enriquewph/TD1-MiniLab/hw-minilab/bornera.png

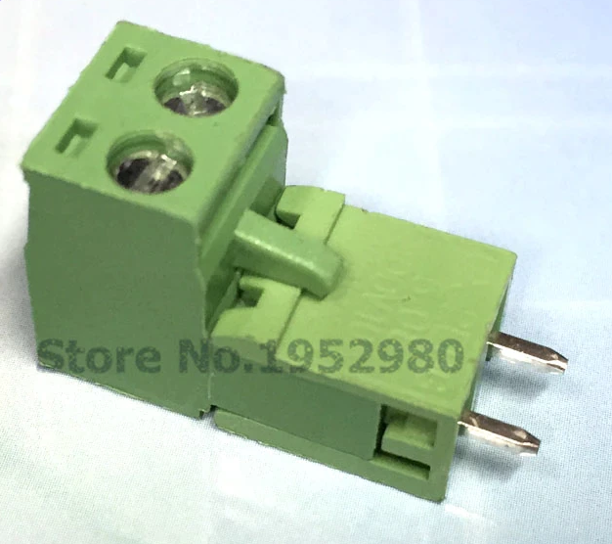
hw-minilab/bornera.png
