enriquewph/TD1-MiniLab/CAD/Render A.JPG

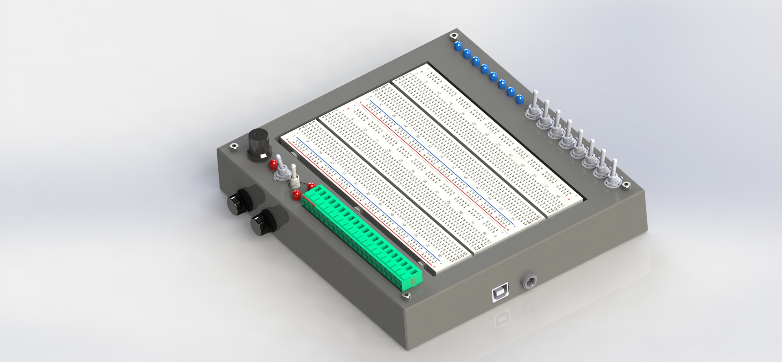
CAD/Render A.JPG
