enriquewph/TD1-MiniLab/README.md

# TD1-MiniLab
Practico de Laboratorio N° 1. --- Mini Lab ---
