enriquewph/TD1-MiniLab/CAD/render 1.JPG

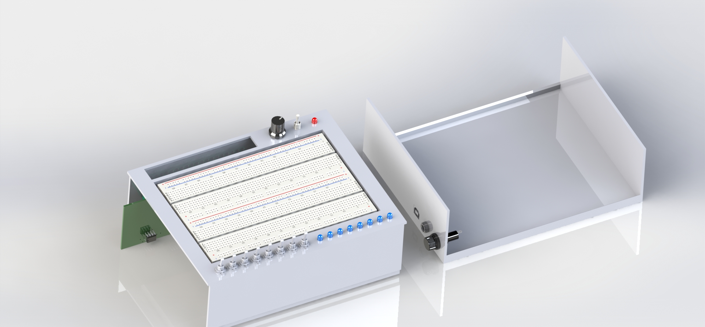
CAD/render 1.JPG
