enriquewph/TD1-MiniLab/CAD/Render B.JPG

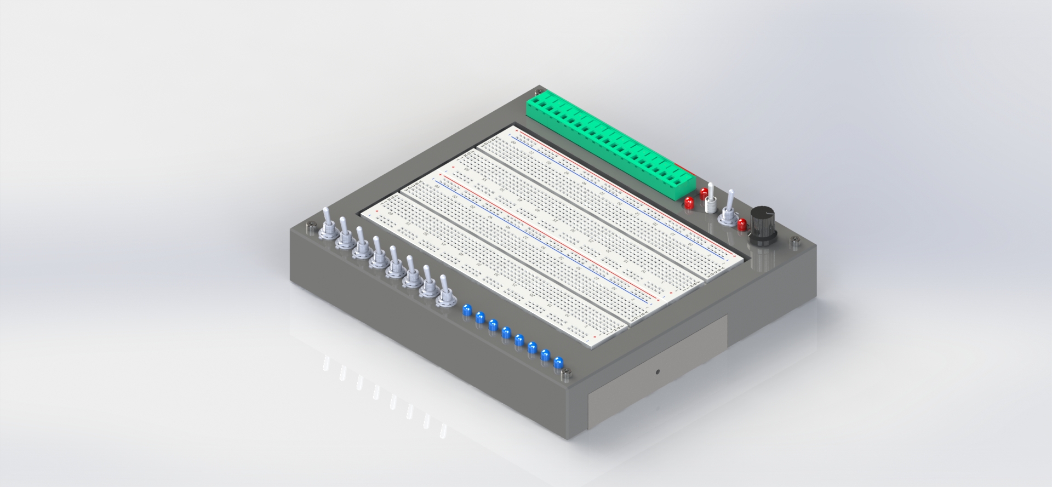
CAD/Render B.JPG
