enriquewph/TD1-MiniLab/hw-minilab/docs/BOM.xlsx

Sheet: Resumen
Item | Cantidad | Descripción | Valor | Cant. Necesaria Total | Cant. Obtenida | Excedentes | Costo c/u | Costo total | Costo x Minilab
1 | 1 | C. Integrado | NE555P | 4 | 6 | 2 | $209.05 | $1254.32 | $313.58
2 | 1 | C. Integrado | L7805 | 4 | 4 | 0 | $40.84 | $163.36 | $40.84
3 | 1 | C. Integrado | KF33 | 4 | 4 | 0 | $40.84 | $163.36 | $40.84
4 | 2 | C. Integrado | CD4069 | 8 | 12 | 4 | $109.20 | $1310.40 | $327.60
5 | 1 | Cap. Cerámico 50V | 470nF | 4 | 4 | 0 | $18.20 | $72.80 | $18.20
6 | 8 | Cap. Cerámico 50V | 100nF | 32 | 32 | 0 | $7.00 | $224.00 | $56.00
7 | 2 | Cap. Electrolítico 16V | 10uF | 8 | 8 | 0 | $3.91 | $31.31 | $7.83
8 | 2 | Cap. Electrolítico 16V | 100uF | 8 | 8 | 0 | $3.91 | $31.31 | $7.83
9 | 7 | Conector Bornera 3 Pos. 5.08mm | - | 28 | 28 | 0 | $85.00 | $2380.00 | $595.00
10 | 1 | Conector DC Estándar p/gab | - | 4 | 4 | 0 | $100.00 | $400.00 | $100.00
11 | 1 | Diodo Rectificador | 1N4007 | 4 | 4 | 0 | $2.50 | $10.00 | $2.50
12 | 1 | Disipador TO220 7W | - | 4 | 4 | 0 | $0.00 | $0.00 | $0.00
13 | 7 | Enchufe Bornera 3 Pos. 5.08mm | - | 28 | 28 | 0 | $25.00 | $700.00 | $175.00
14 | 6 | Fusible 20mm | 250mA | 24 | 24 | 0 | $23.80 | $571.20 | $142.80
15 | 8 | Imanes Neodimio 5x1mm | - | 32 | 32 | 0 | $36.00 | $1152.00 | $288.00
16 | 8 | LED 5mm Azul | - | 32 | 32 | 0 | $5.00 | $160.00 | $40.00
17 | 3 | LED 5mm Rojo | - | 12 | 12 | 0 | $5.00 | $60.00 | $15.00
18 | 1 | Placa Virgen 20x20 | - | 1 | 1 | 0 | $266.00 | $266.00 | $66.50
19 | 2 | Portafusible p/gab | - | 8 | 8 | 0 | $82.60 | $660.80 | $165.20
20 | 1 | Potenciometro p/gabinete | 1M | 4 | 4 | 0 | $138.60 | $554.40 | $138.60
21 | 1 | Power Bank barato 1x18650 | - | 4 | 4 | 0 | $800.00 | $3200.00 | $800.00
22 | 2 | Protoboard 830 puntos | - | 8 | 8 | 0 | $214.00 | $1712.00 | $428.00
23 | 1 | Resistencia 1/4 W | 2k7 | 4 | 50 | 46 | $1.54 | $76.87 | $19.22
24 | 11 | Resistencia 1/4 W | 470 | 44 | 50 | 6 | $1.54 | $76.87 | $19.22
25 | 16 | Resistencia 1/4 W | 10k | 64 | 100 | 36 | $1.54 | $153.73 | $38.43
26 | 9 | Switch Palanca ON/ON | SW_SPDT | 36 | 36 | 0 | $61.49 | $2213.72 | $553.43
27 | 1 | Switch Palanca ON/ON | SW_DPDT | 4 | 4 | 0 | $197.82 | $791.29 | $197.82
28 | 1 | USB Tipo B Hembra | - | 4 | 4 | 0 | $61.26 | $245.04 | $61.26
29 | 2 | Zocalo DIP 14 | - | 8 | 8 | 0 | $10.00 | $80.00 | $20.00
30 | 1 | Zocalo DIP 8 | - | 4 | 4 | 0 | $10.00 | $40.00 | $10.00
31 | 4 | Tornillos M3x20 | - | 16 | 16 | 0 | $20.00 | $320.00 | $80.00
32 | 7 | Tornillos M3x15 | - | 28 | 28 | 0 | $18.00 | $504.00 | $126.00
33 | 4 | Tuercas M3 | - | 16 | 16 | 0 | $2.00 | $32.00 | $8.00
Total |  |  |  |  |  |  |  |  | $4902.69

Sheet: Completo
Item | Cantidad | Descripción | Valor | Cant. Necesaria Total | Cant. Obtenida | Excedentes | Costo c/u | Costo total | Costo x Minilab
1 | 1 | C. Integrado | NE555P | 4 | 6 | 2 | $209.05 | $1254.32 | $313.58
2 | 1 | C. Integrado | L7805 | 4 | 4 | 0 | $40.84 | $163.36 | $40.84
3 | 1 | C. Integrado | KF33 | 4 | 4 | 0 | $40.84 | $163.36 | $40.84
4 | 2 | C. Integrado | CD4069 | 8 | 12 | 4 | $109.20 | $1310.40 | $327.60
5 | 1 | Cap. Cerámico 50V | 470nF | 4 | 4 | 0 | $18.20 | $72.80 | $18.20
6 | 8 | Cap. Cerámico 50V | 100nF | 32 | 32 | 0 | $7.00 | $224.00 | $56.00
7 | 2 | Cap. Electrolítico 16V | 10uF | 8 | 8 | 0 | $3.91 | $31.31 | $7.83
8 | 2 | Cap. Electrolítico 16V | 100uF | 8 | 8 | 0 | $3.91 | $31.31 | $7.83
9 | 7 | Conector Bornera 3 Pos. 5.08mm | - | 28 | 28 | 0 | $85.00 | $2380.00 | $595.00
10 | 1 | Conector DC Estándar p/gab | - | 4 | 4 | 0 | $100.00 | $400.00 | $100.00
11 | 1 | Diodo Rectificador | 1N4007 | 4 | 4 | 0 | $2.50 | $10.00 | $2.50
12 | 1 | Disipador TO220 7W | - | 4 | 4 | 0 | $0.00 | $0.00 | $0.00
13 | 7 | Enchufe Bornera 3 Pos. 5.08mm | - | 28 | 28 | 0 | $25.00 | $700.00 | $175.00
14 | 6 | Fusible 20mm | 250mA | 24 | 24 | 0 | $23.80 | $571.20 | $142.80
15 | 8 | Imanes Neodimio 5x1mm | - | 32 | 32 | 0 | $36.00 | $1152.00 | $288.00
16 | 8 | LED 5mm Azul | - | 32 | 32 | 0 | $5.00 | $160.00 | $40.00
17 | 3 | LED 5mm Rojo | - | 12 | 12 | 0 | $5.00 | $60.00 | $15.00
18 | 1 | Placa Virgen 20x20 | - | 1 | 1 | 0 | $266.00 | $266.00 | $66.50
19 | 2 | Portafusible p/gab | - | 8 | 8 | 0 | $82.60 | $660.80 | $165.20
20 | 1 | Potenciometro p/gabinete | 1M | 4 | 4 | 0 | $138.60 | $554.40 | $138.60
21 | 1 | Power Bank barato 1x18650 | - | 4 | 4 | 0 | $800.00 | $3200.00 | $800.00
22 | 2 | Protoboard 830 puntos | - | 8 | 8 | 0 | $214.00 | $1712.00 | $428.00
23 | 1 | Resistencia 1/4 W | 2k7 | 4 | 50 | 46 | $1.54 | $76.87 | $19.22
24 | 11 | Resistencia 1/4 W | 470 | 44 | 50 | 6 | $1.54 | $76.87 | $19.22
25 | 16 | Resistencia 1/4 W | 10k | 64 | 100 | 36 | $1.54 | $153.73 | $38.43
26 | 9 | Switch Palanca ON/ON | SW_SPDT | 36 | 36 | 0 | $61.49 | $2213.72 | $553.43
27 | 1 | Switch Palanca ON/ON | SW_DPDT | 4 | 4 | 0 | $197.82 | $791.29 | $197.82
28 | 1 | USB Tipo B Hembra | - | 4 | 4 | 0 | $61.26 | $245.04 | $61.26
29 | 2 | Zocalo DIP 14 | - | 8 | 8 | 0 | $10.00 | $80.00 | $20.00
30 | 1 | Zocalo DIP 8 | - | 4 | 4 | 0 | $10.00 | $40.00 | $10.00
Total |  |  |  |  |  |  |  |  | $4688.69
