enriquewph/TD1-MiniLab/CAD/Jack_DC.SLDASM

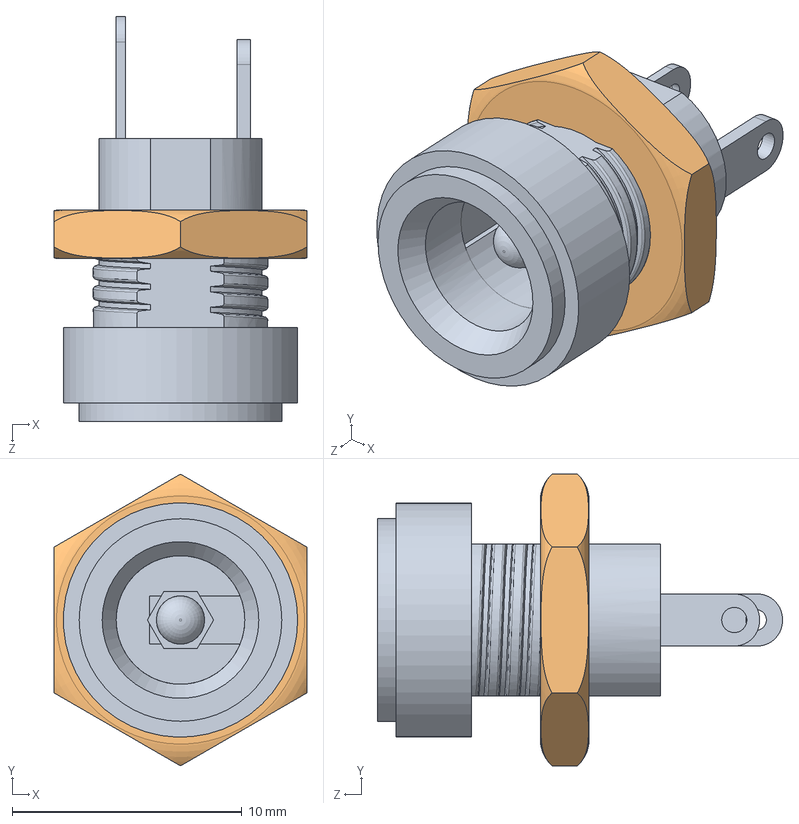
[picture p5: CAD file, 2022-03-29]
CAD/Jack_DC.SLDASM
11.0 x 12.7 x 17.6 mm
DC Jack Panel Mount Base_1
DC Jack Panel Mount Nut_1
