enriquewph/TD1-MiniLab/CAD/minilab-export.SLDASM

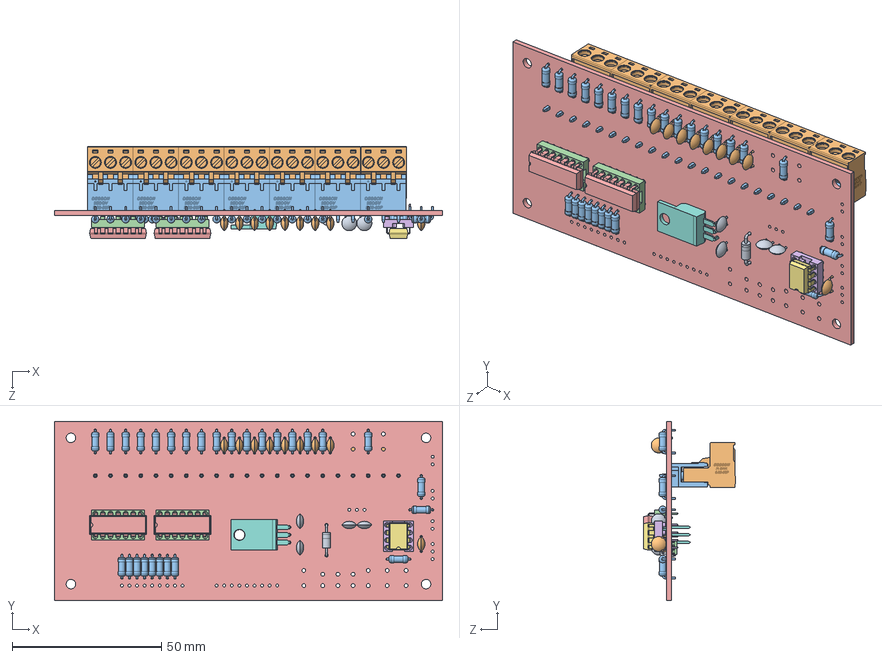
[picture p6: CAD file, 2022-03-29]
CAD/minilab-export.SLDASM
130.0 x 60.0 x 30.8 mm
SOLID.step x 4
SOLID-0.step x 9
SOLID-1.step x 28
SOLID-2.step x 2
SOLID-3.step x 2
SOLID-4.step
SOLID-5.step
SOLID-6.step
SOLID-7.step
SOLID-8.step x 7
SOLID-9.step x 7
SOLID-10.step
minilab PCB.step
