enriquewph/TD1-MiniLab/CAD/Pcb.SLDASM

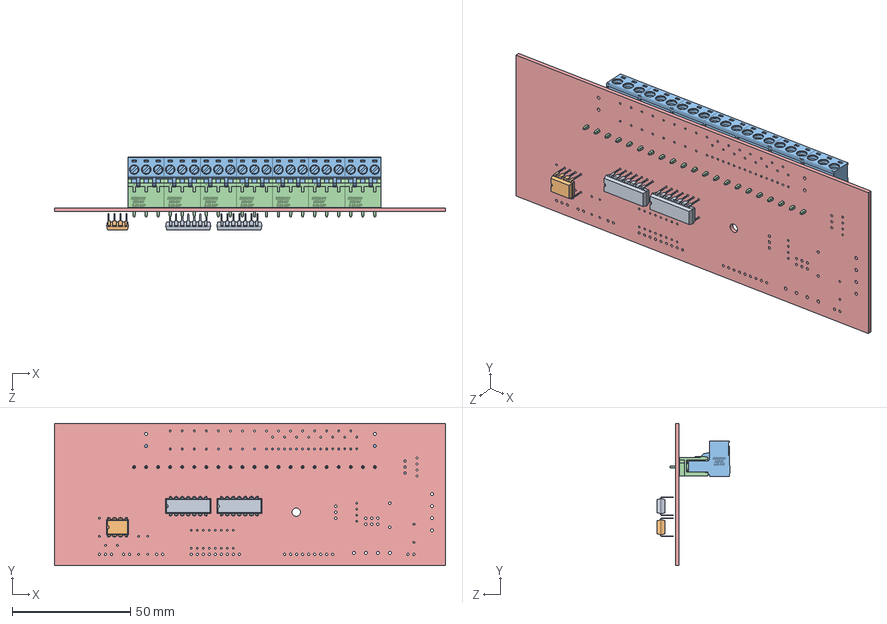
[picture p7: CAD file, 2022-03-29]
CAD/Pcb.SLDASM
165.0 x 60.0 x 30.8 mm
minilab PCB
