enriquewph/TD1-MiniLab/CAD/RTP/Base-Insertos.STL

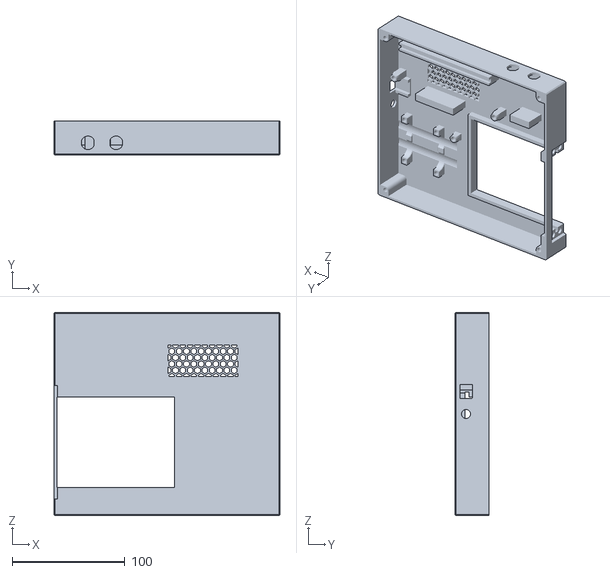
[picture p8: CAD file, 2022-03-29]
CAD/RTP/Base-Insertos.STL
200.0 x 30.5 x 180.0
