enriquewph/TD1-MiniLab/CAD/RTP/Tapa.STL

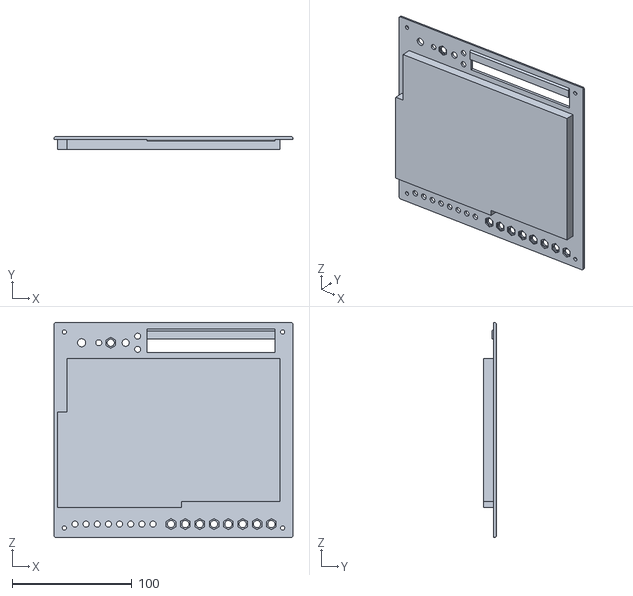
[picture p9: CAD file, 2022-03-29]
CAD/RTP/Tapa.STL
200.0 x 11.0 x 180.0
