enriquewph/TD1-MiniLab/CAD/Turn Knob.SLDPRT

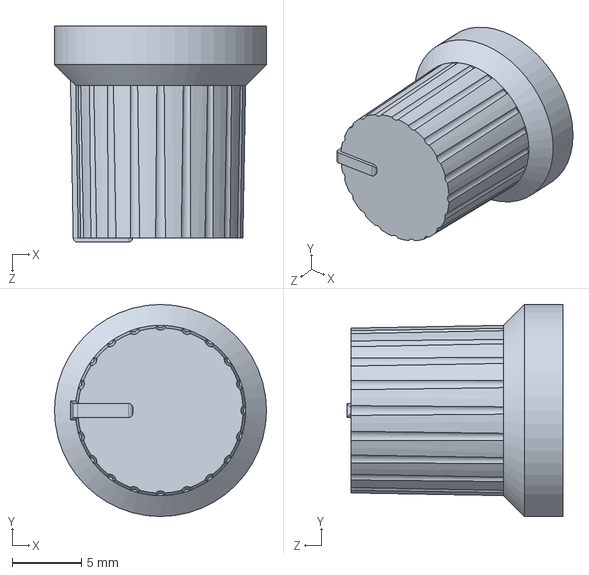
[picture p10: CAD file, 2022-03-29]
CAD/Turn Knob.SLDPRT
15.3 x 15.3 x 15.6 mm
