enriquewph/TD1-MiniLab/CAD/LED_BLUE.SLDPRT

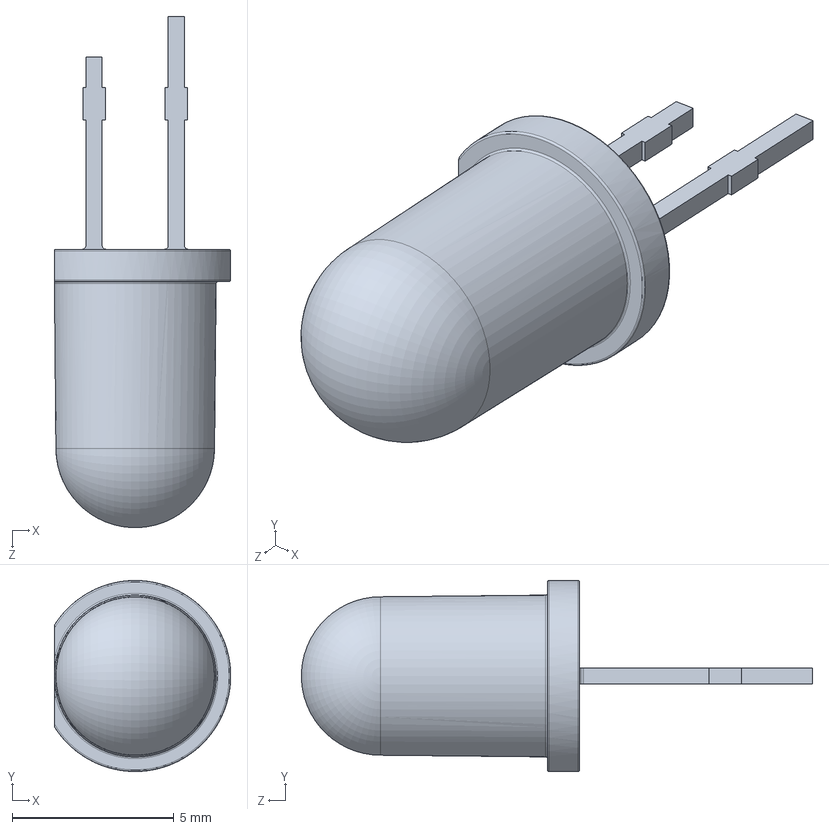
[picture p11: CAD file, 2022-03-29]
CAD/LED_BLUE.SLDPRT
5.45 x 5.90 x 15.8 mm
