enriquewph/TD1-MiniLab/CAD/RTP/Cajon.STL

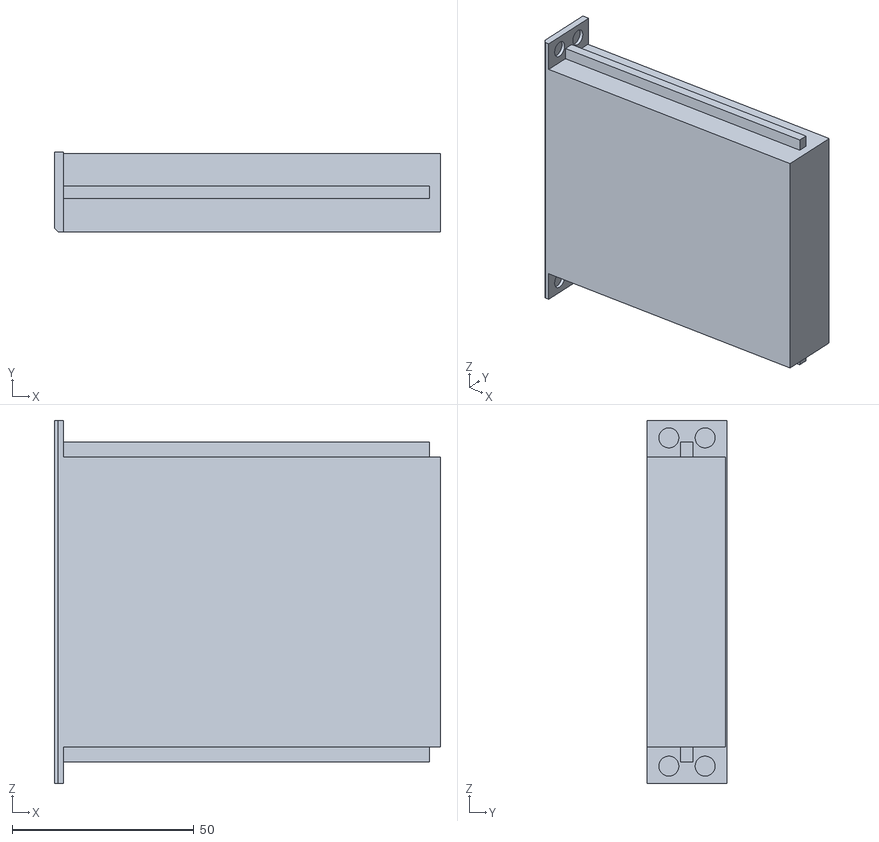
[picture p12: CAD file, 2022-03-29]
CAD/RTP/Cajon.STL
106.3 x 22.0 x 100.0
