enriquewph/TD1-MiniLab/CAD/RTP/Clips.STL

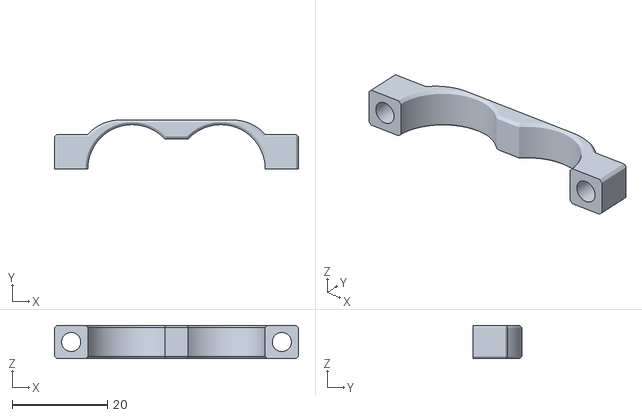
[picture p13: CAD file, 2022-03-29]
CAD/RTP/Clips.STL
51.2 x 10.3 x 7.00
