enriquewph/TD1-MiniLab/CAD/DPDTINVERSOR.SLDPRT

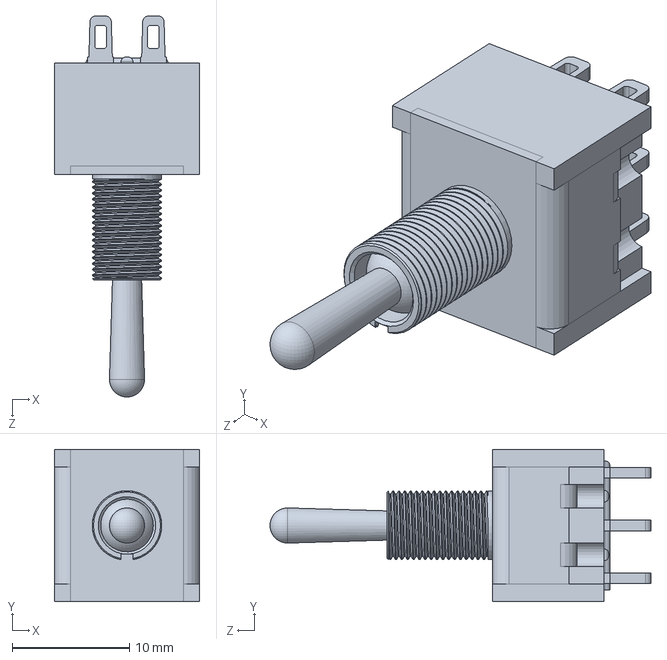
[picture p14: CAD file, 2022-03-29]
CAD/DPDTINVERSOR.SLDPRT
12.4 x 13.0 x 32.5 mm
