enriquewph/TD1-MiniLab/CAD/USB_B_Type.SLDPRT

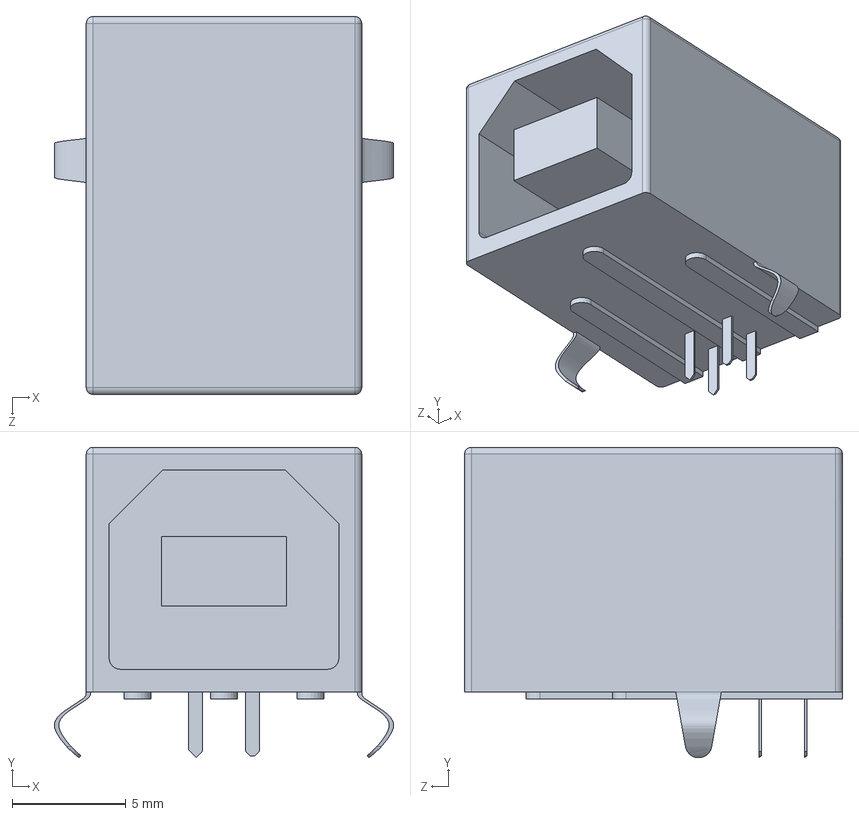
[picture p15: CAD file, 2022-03-29]
CAD/USB_B_Type.SLDPRT
14.9 x 13.6 x 16.6 mm
