enriquewph/TD1-MiniLab/CAD/SPDT.SLDPRT

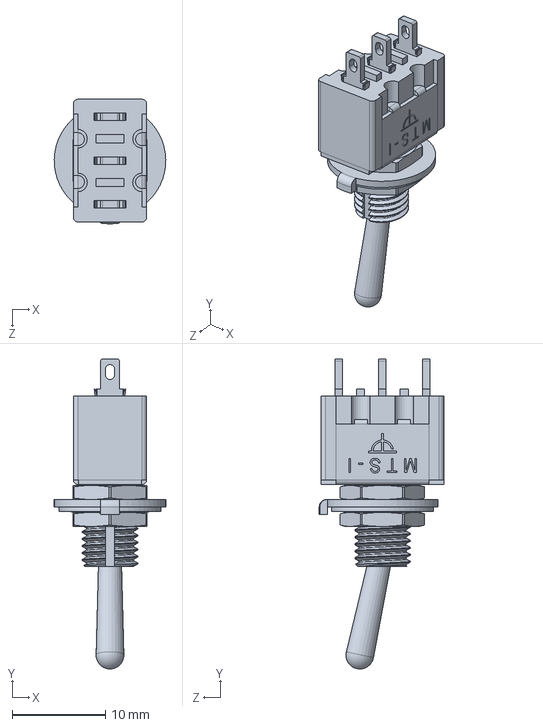
[picture p16: CAD file, 2022-03-29]
CAD/SPDT.SLDPRT
12.0 x 33.3 x 13.4 mm
