enriquewph/TD1-MiniLab/CAD/FuseHolder.SLDPRT

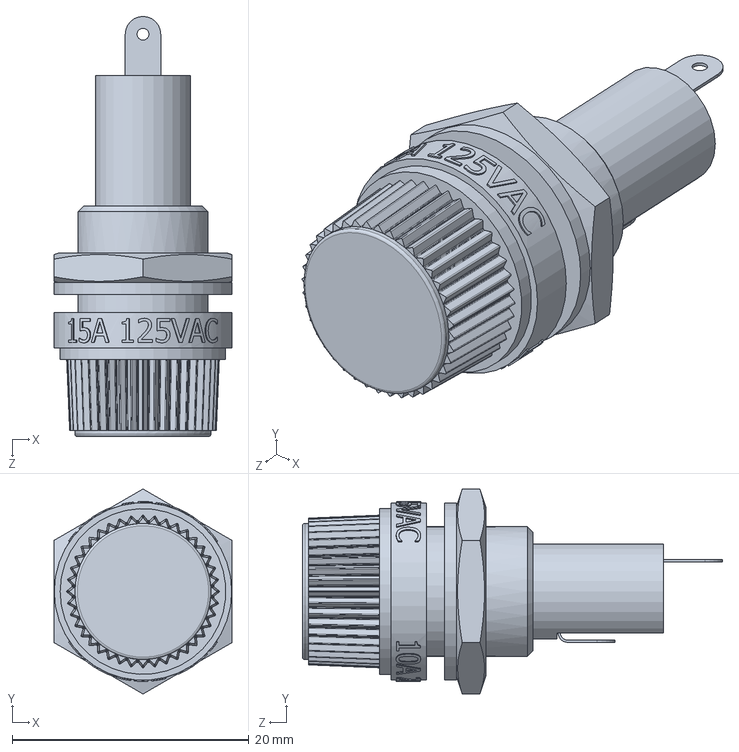
[picture p17: CAD file, 2022-03-29]
CAD/FuseHolder.SLDPRT
15.0 x 17.3 x 35.5 mm
