enriquewph/TD1-MiniLab/CAD/BORNIER3PINMALE.SLDPRT

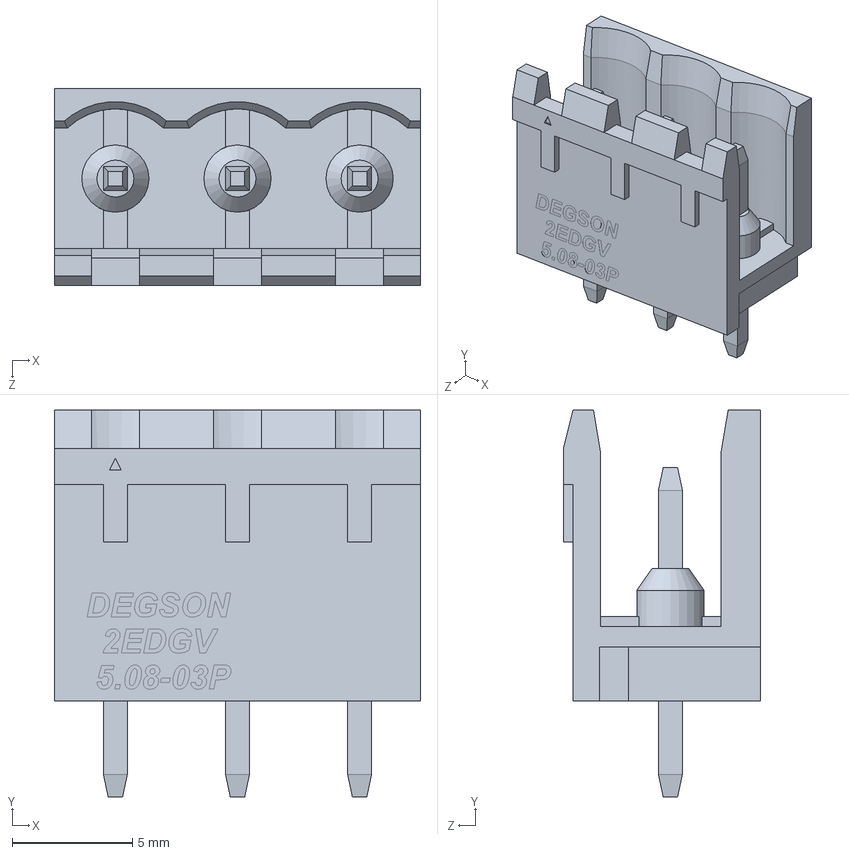
[picture p18: CAD file, 2022-03-29]
CAD/BORNIER3PINMALE.SLDPRT
15.2 x 16.1 x 8.20 mm
