enriquewph/TD1-MiniLab/CAD/BORNIER3PINFEM.SLDPRT

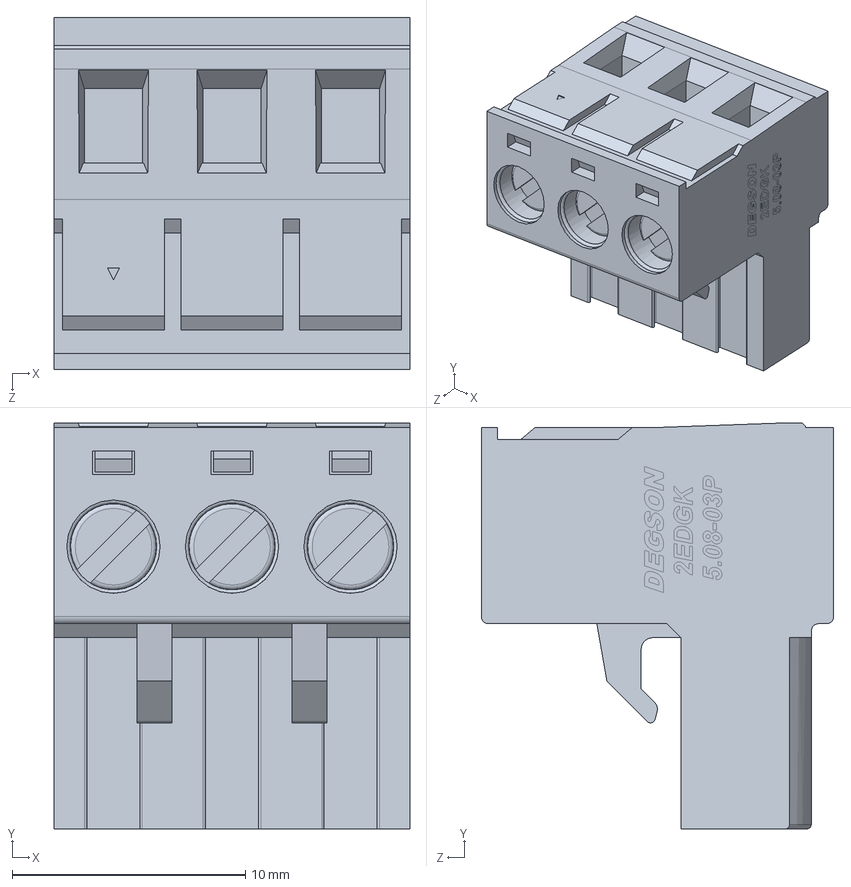
[picture p19: CAD file, 2022-03-29]
CAD/BORNIER3PINFEM.SLDPRT
15.2 x 17.4 x 15.1 mm
