enriquewph/TD1-MiniLab/CAD/Base.SLDPRT

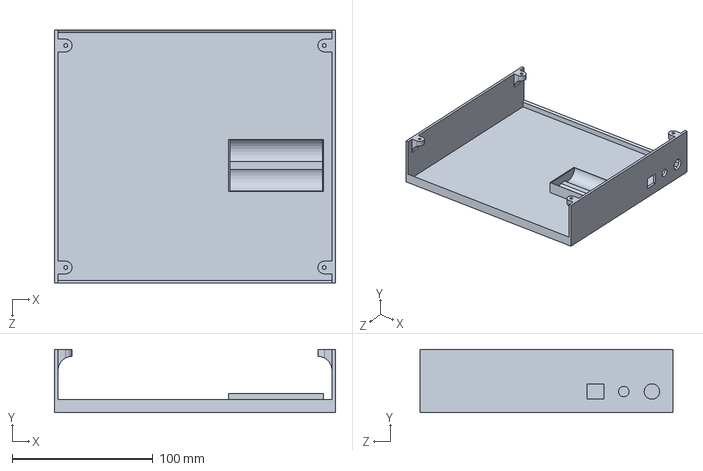
[picture p20: CAD file, 2022-03-29]
CAD/Base.SLDPRT
200.0 x 45.0 x 180.0 mm
