enriquewph/TD1-MiniLab/CAD/Samsung ICR 4200 mAh.stp

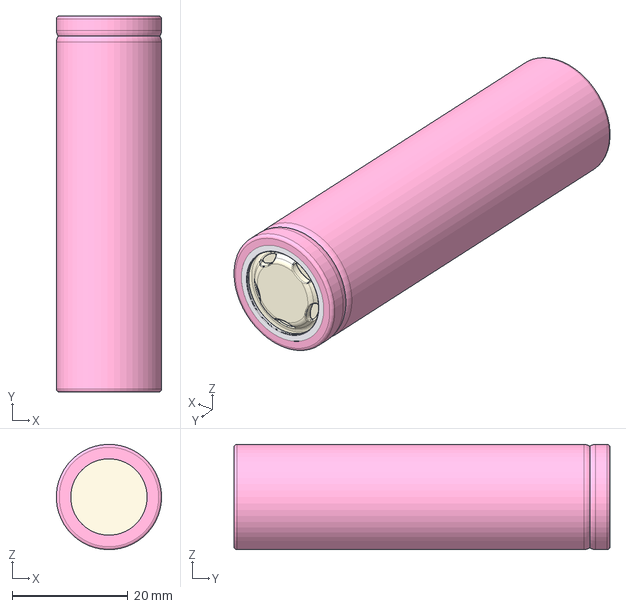
[picture p21: CAD file, 2022-03-29]
CAD/Samsung ICR 4200 mAh.stp
18.2 x 65.0 x 18.2 mm
