enriquewph/TD1-MiniLab/CAD/Case.SLDPRT

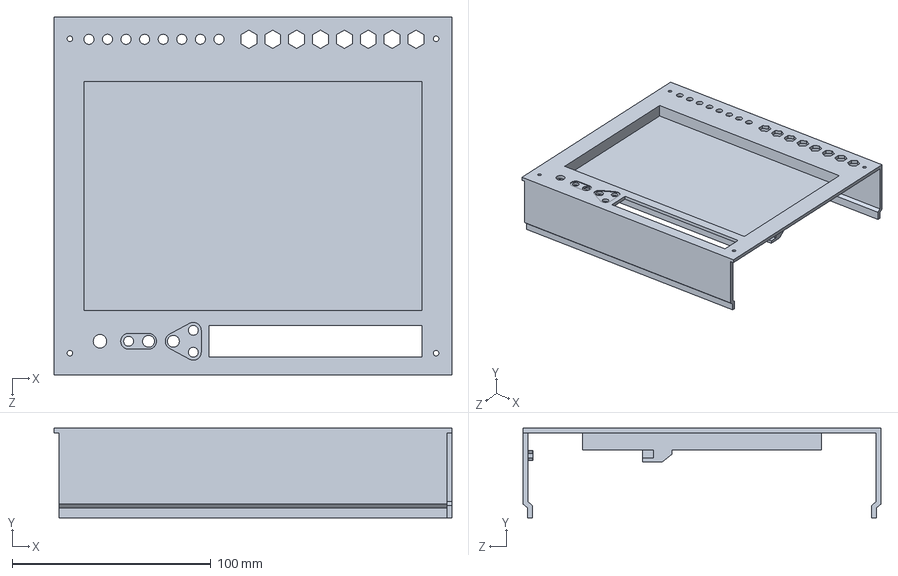
[picture p22: CAD file, 2022-03-29]
CAD/Case.SLDPRT
200.0 x 45.0 x 180.0 mm
