enriquewph/TD1-MiniLab/(list of files, cad)

Other CAD files:
CAD/R_Axial_DIN0207_L6.3mm_D2.5mm_P7.62mm_Horizontal.step_3.sldasm
CAD/R_Axial_DIN0207_L6.3mm_D2.5mm_P7.62mm_Horizontal.step_13.sldasm
CAD/R_Axial_DIN0207_L6.3mm_D2.5mm_P7.62mm_Horizontal.step_21.sldasm
CAD/C_Disc_D5.0mm_W2.5mm_P2.50mm.step.sldasm
CAD/2EDGV-5.08-03P-14-00AH.step_3.sldasm
CAD/2EDGV-5.08-03P-14-00AH.step_2.sldasm
CAD/DIP-8_W7.62mm_Socket.step.sldasm
CAD/C_Disc_D5.0mm_W2.5mm_P5.00mm.step_4.sldasm
CAD/DIP-14_W7.62mm_Socket.sldasm
CAD/C_Disc_D5.0mm_W2.5mm_P2.50mm.step_4.sldasm
CAD/R_Axial_DIN0207_L6.3mm_D2.5mm_P7.62mm_Horizontal.step_5.sldasm
CAD/C_Disc_D5.0mm_W2.5mm_P2.50mm.step_3.sldasm
CAD/R_Axial_DIN0207_L6.3mm_D2.5mm_P7.62mm_Horizontal.step_26.sldasm
CAD/SOIC-8-1EP_3.9x4.9mm_P1.27mm_EP2.35x2.35mm.step.sldasm
CAD/C_Disc_D5.0mm_W2.5mm_P5.00mm.step_8.sldasm
CAD/2EDGK-5.08-03P-14-00AH.step_6.sldasm
CAD/R_Axial_DIN0207_L6.3mm_D2.5mm_P7.62mm_Horizontal.step_14.sldasm
CAD/C_Disc_D5.0mm_W2.5mm_P5.00mm.step_6.sldasm
CAD/C_Disc_D5.0mm_W2.5mm_P5.00mm.sldasm
CAD/R_Axial_DIN0207_L6.3mm_D2.5mm_P7.62mm_Horizontal.step_4.sldasm
CAD/DIP-14_W7.62mm_1.sldasm
CAD/R_Axial_DIN0207_L6.3mm_D2.5mm_P7.62mm_Horizontal.step_18.sldasm
CAD/2EDGV-5.08-03P-14-00AH.step.sldasm
CAD/2EDGK-5.08-03P-14-00AH.step_5.sldasm
CAD/R_Axial_DIN0207_L6.3mm_D2.5mm_P7.62mm_Horizontal.step_24.sldasm
CAD/R_Axial_DIN0207_L6.3mm_D2.5mm_P7.62mm_Horizontal.step_20.sldasm
CAD/R_Axial_DIN0207_L6.3mm_D2.5mm_P7.62mm_Horizontal.step_11.sldasm
CAD/R_Axial_DIN0207_L6.3mm_D2.5mm_P7.62mm_Horizontal.step_8.sldasm
CAD/2EDGV-5.08-03P-14-00AH.step_6.sldasm
CAD/R_Axial_DIN0207_L6.3mm_D2.5mm_P7.62mm_Horizontal.step_9.sldasm
CAD/2EDGV-5.08-03P-14-00AH.step_7.sldasm
CAD/DIP-14_W7.62mm.sldasm
CAD/2EDGK-5.08-03P-14-00AH.step_7.sldasm
CAD/2EDGV-5.08-03P-14-00AH.step_4.sldasm
CAD/R_Axial_DIN0207_L6.3mm_D2.5mm_P7.62mm_Horizontal.step_19.sldasm
CAD/C_Disc_D5.0mm_W2.5mm_P5.00mm.step_9.sldasm
CAD/DIP-14_W7.62mm_Socket.step_2.sldasm
CAD/TO-220-3_Horizontal_TabUp.step.sldasm
CAD/R_Axial_DIN0207_L6.3mm_D2.5mm_P7.62mm_Horizontal.step_23.sldasm
CAD/D_DO-41_SOD81_P10.16mm_Horizontal.sldasm
CAD/C_Disc_D5.0mm_W2.5mm_P2.50mm.step_2.sldasm
CAD/R_Axial_DIN0207_L6.3mm_D2.5mm_P7.62mm_Horizontal.step_16.sldasm
CAD/C_Disc_D5.0mm_W2.5mm_P5.00mm.step_5.sldasm
CAD/R_Axial_DIN0207_L6.3mm_D2.5mm_P7.62mm_Horizontal.step_28.sldasm
CAD/DIP-8_W7.62mm_Socket.sldasm
CAD/2EDGV-5.08-03P-14-00AH_1.sldasm
CAD/TO-220-3_Horizontal_TabUp.sldasm
CAD/D_DO-41_SOD81_P10.16mm_Horizontal.step.sldasm
CAD/2EDGV-5.08-03P-14-00AH.step_5.sldasm
CAD/2EDGK-5.08-03P-14-00AH_1.sldasm
CAD/R_Axial_DIN0207_L6.3mm_D2.5mm_P7.62mm_Horizontal.step_15.sldasm
CAD/2EDGK-5.08-03P-14-00AH.step_4.sldasm
CAD/minilab.SLDASM
CAD/DIP-14_W7.62mm.step_2.sldasm
CAD/2EDGK-5.08-03P-14-00AH.step_3.sldasm
CAD/C_Disc_D5.0mm_W2.5mm_P5.00mm.step_7.sldasm
CAD/DIP-8_W7.62mm.sldasm
CAD/SOIC-8-1EP_3.9x4.9mm_P1.27mm_EP2.35x2.35mm.sldasm
CAD/C_Disc_D5.0mm_W2.5mm_P2.50mm.sldasm
CAD/C_Disc_D5.0mm_W2.5mm_P5.00mm.step_2.sldasm
CAD/R_Axial_DIN0207_L6.3mm_D2.5mm_P7.62mm_Horizontal.step_27.sldasm
CAD/R_Axial_DIN0207_L6.3mm_D2.5mm_P7.62mm_Horizontal.step_2.sldasm
CAD/R_Axial_DIN0207_L6.3mm_D2.5mm_P7.62mm_Horizontal.step_17.sldasm
CAD/DIP-14_W7.62mm_Socket.step.sldasm
CAD/R_Axial_DIN0207_L6.3mm_D2.5mm_P7.62mm_Horizontal.step.sldasm
CAD/2EDGK-5.08-03P-14-00AH.step_2.sldasm
CAD/R_Axial_DIN0207_L6.3mm_D2.5mm_P7.62mm_Horizontal.step_25.sldasm
CAD/DIP-14_W7.62mm.step.sldasm
CAD/2EDGK-5.08-03P-14-00AH.step.sldasm
CAD/DIP-8_W7.62mm.step.sldasm
CAD/R_Axial_DIN0207_L6.3mm_D2.5mm_P7.62mm_Horizontal.step_10.sldasm
CAD/R_Axial_DIN0207_L6.3mm_D2.5mm_P7.62mm_Horizontal.step_7.sldasm
CAD/C_Disc_D5.0mm_W2.5mm_P5.00mm.step_3.sldasm
CAD/R_Axial_DIN0207_L6.3mm_D2.5mm_P7.62mm_Horizontal.step_6.sldasm
CAD/DIP-8_W7.62mm_1.sldasm
CAD/R_Axial_DIN0207_L6.3mm_D2.5mm_P7.62mm_Horizontal.step_22.sldasm
CAD/R_Axial_DIN0207_L6.3mm_D2.5mm_P7.62mm_Horizontal.step_12.sldasm
CAD/minilab.step.sldasm
CAD/R_Axial_DIN0207_L6.3mm_D2.5mm_P7.62mm_Horizontal.sldasm
CAD/C_Disc_D5.0mm_W2.5mm_P5.00mm.step.sldasm
CAD/RED_LED.SLDPRT
CAD/DC Jack Panel Mount Base_1.sldprt
CAD/clip-bateria.SLDPRT
CAD/Cajon.SLDPRT
CAD/Case-quique.SLDPRT
CAD/Base-quique.SLDPRT
CAD/minilab PCB.sldprt
CAD/SOLID_2.sldprt
CAD/SOLID-5.step.sldprt
CAD/SOLID_1_2.sldprt
CAD/SOLID_1_9.sldprt
CAD/SOLID.step.sldprt
CAD/SOLID_1_11.sldprt
CAD/SOLID_1_10.sldprt
CAD/SOLID-8.step.sldprt
CAD/SOLID-6.step.sldprt
CAD/SOLID_4.sldprt
CAD/SOLID_1_12.sldprt
CAD/SOLID-2.step.sldprt
CAD/SOLID_1_6.sldprt
CAD/SOLID_3.sldprt
CAD/SOLID-3.step.sldprt
CAD/SOLID-1.step.sldprt
CAD/minilab PCB_1.sldprt
CAD/SOLID_1_7.sldprt
CAD/SOLID-9.step.sldprt
CAD/SOLID_1_3.sldprt
CAD/SOLID-7.step.sldprt
CAD/SOLID_1_4.sldprt
CAD/SOLID-0.step.sldprt
CAD/SOLID_1.sldprt
CAD/SOLID.sldprt
CAD/minilab PCB.step.sldprt
CAD/SOLID-4.step.sldprt
CAD/SOLID-10.step.sldprt
CAD/SOLID_1_8.sldprt
CAD/SOLID_1_5.sldprt
CAD/2EDGK-5.08-03P-14-00AH.STEP
CAD/2EDGV-5.08-03P-14-00AH.STEP
CAD/2EDGK-5.08-03P-14-00AH.sldasm
CAD/2EDGV-5.08-03P-14-00AH.sldasm
CAD/DC Jack Panel Mount Nut_1.sldprt
CAD/Samsung ICR 4200 mAh.SLDPRT
CAD/hex nut style 1_am.sldprt
CAD/hex nut style 1_am2.sldprt
CAD/makeProjectedPlanarWire.x_t
CAD/socket head cap screw_am.sldprt
CAD/socket head cap screw_am2.SLDPRT
CAD/socket head cap screw_am3.sldprt
