enriquewph/TD1-MiniLab/hw-minilab/docs/pcb/pcb-preview.pdf

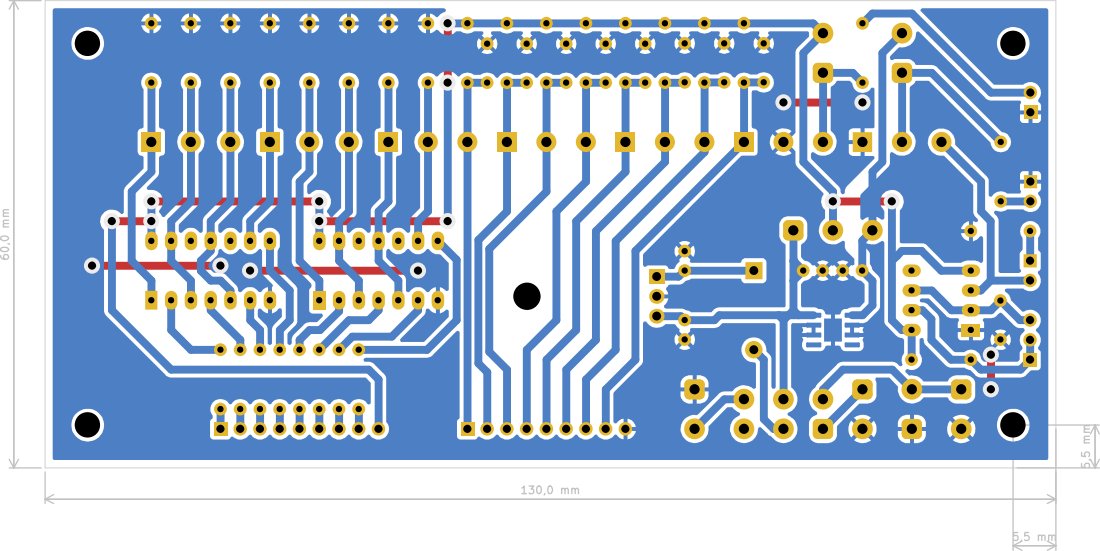
[picture p23: page 1]
