enriquewph/TD1-MiniLab/hw-minilab/docs/sch/minilab.pdf

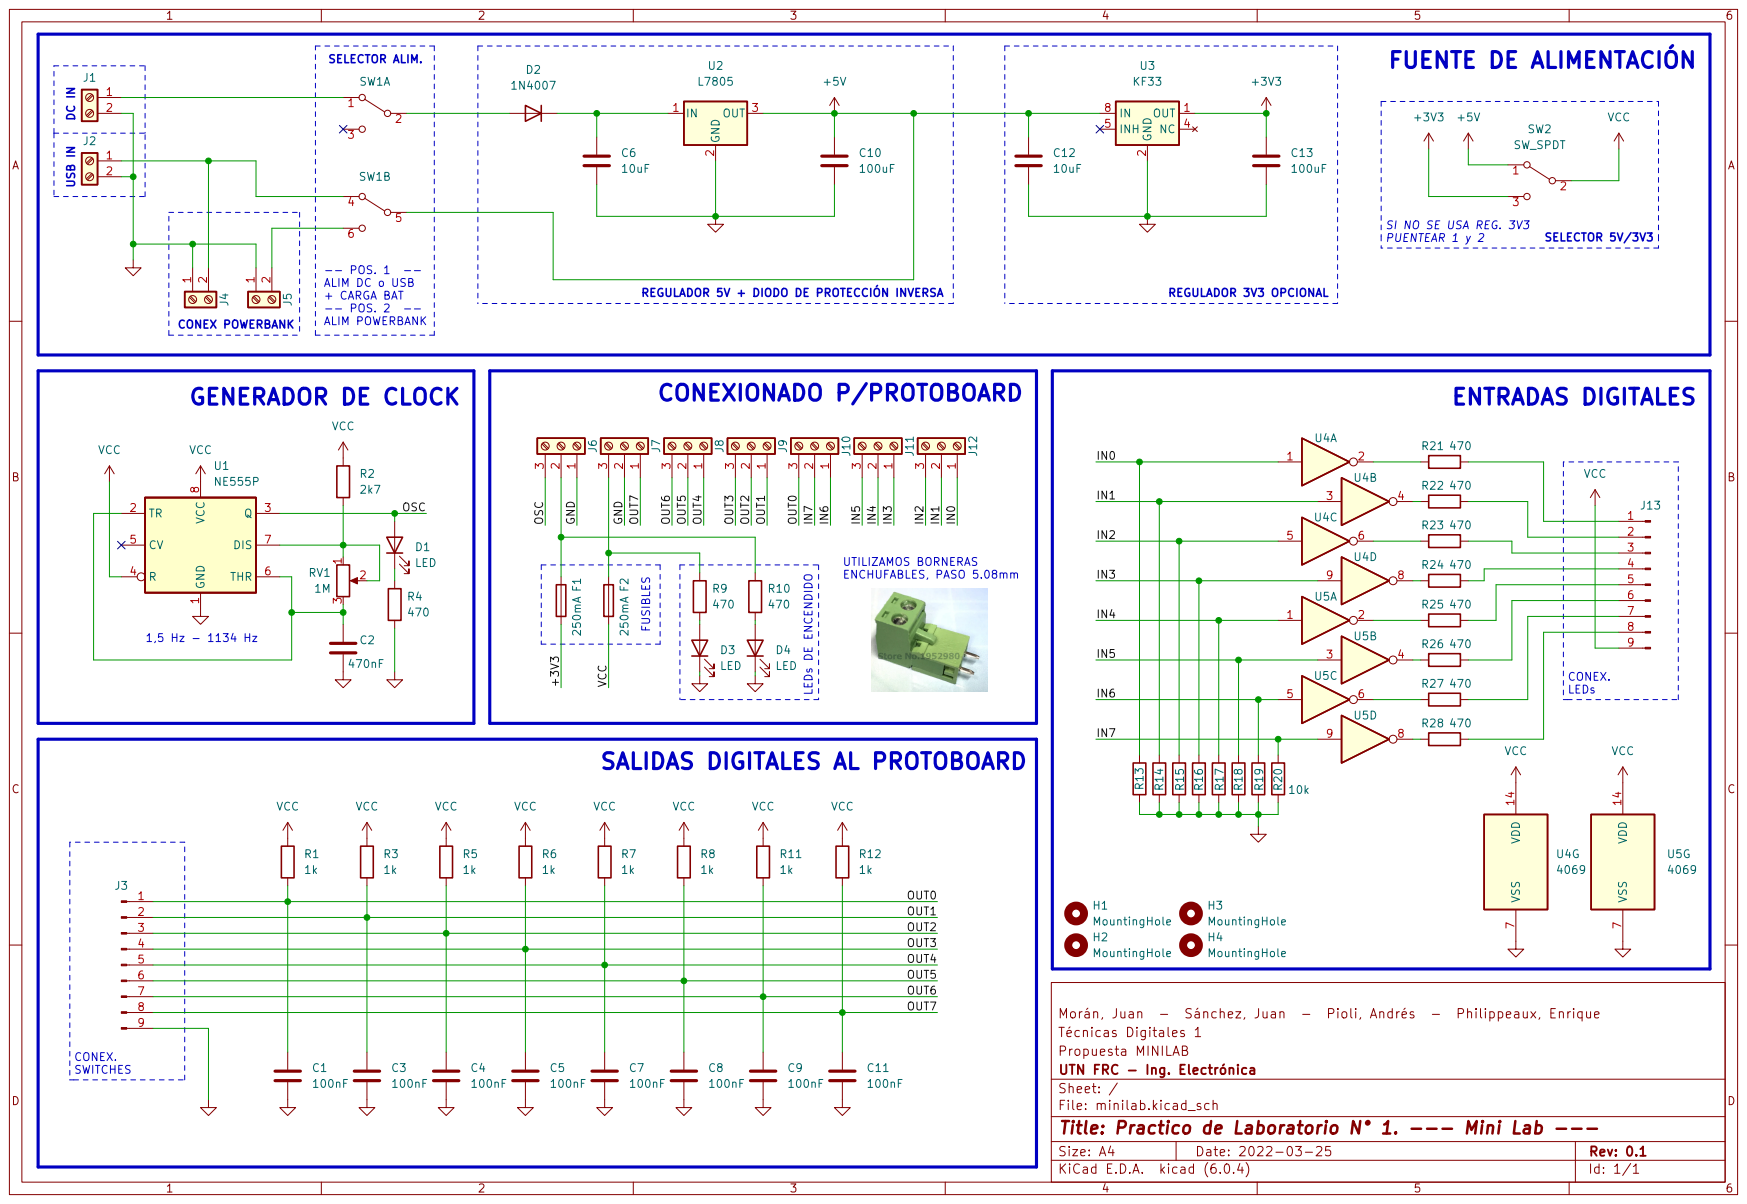
[picture p24: page 1]
