enriquewph/TD1-MiniLab/hw-minilab/docs/pcb/transfer-pcb.pdf

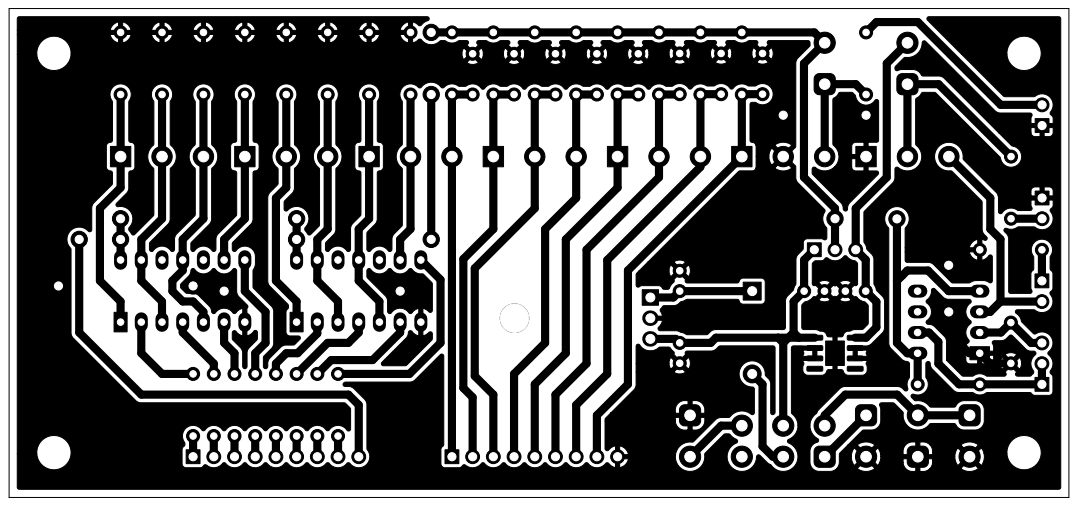
[picture p25: page 1]
