enriquewph/TD1-MiniLab/hw-minilab/docs/sch/individuales/pdf/alimentacion-1.pdf

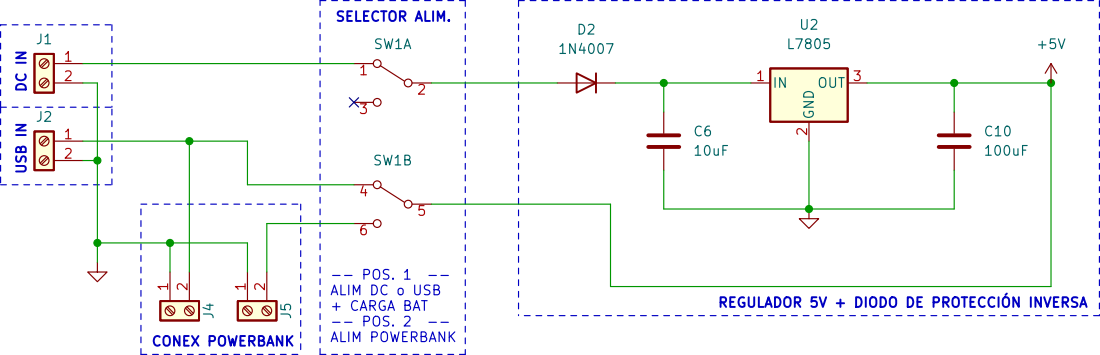
[picture p26: page 1]
