enriquewph/TD1-MiniLab/hw-minilab/docs/sch/individuales/pdf/alimentacion-2.pdf

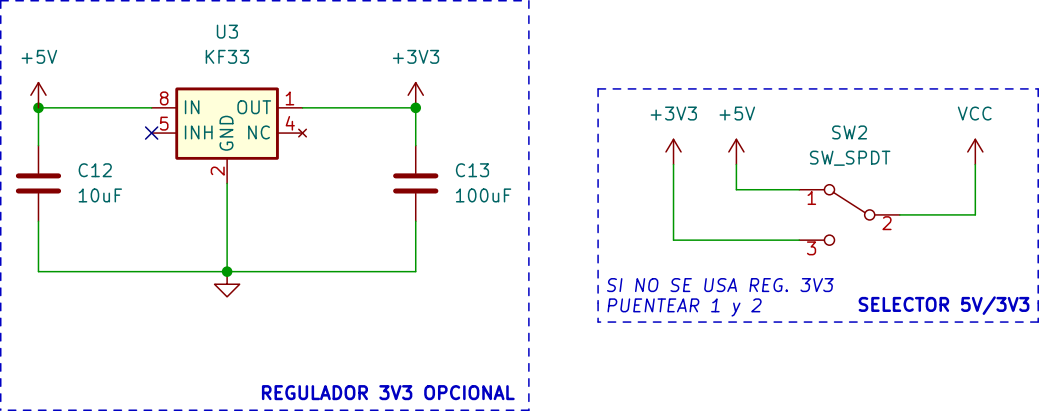
[picture p27: page 1]
