enriquewph/TD1-MiniLab/hw-minilab/docs/sch/individuales/pdf/borneras.pdf

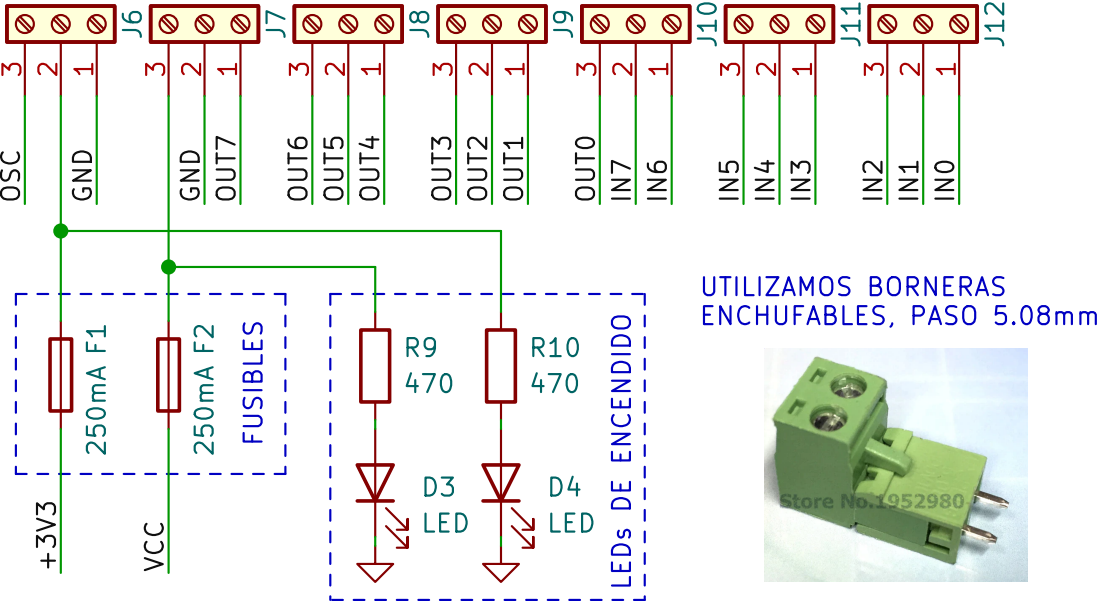
[picture p28: page 1]
