enriquewph/TD1-MiniLab/hw-minilab/docs/sch/individuales/pdf/entradas.pdf

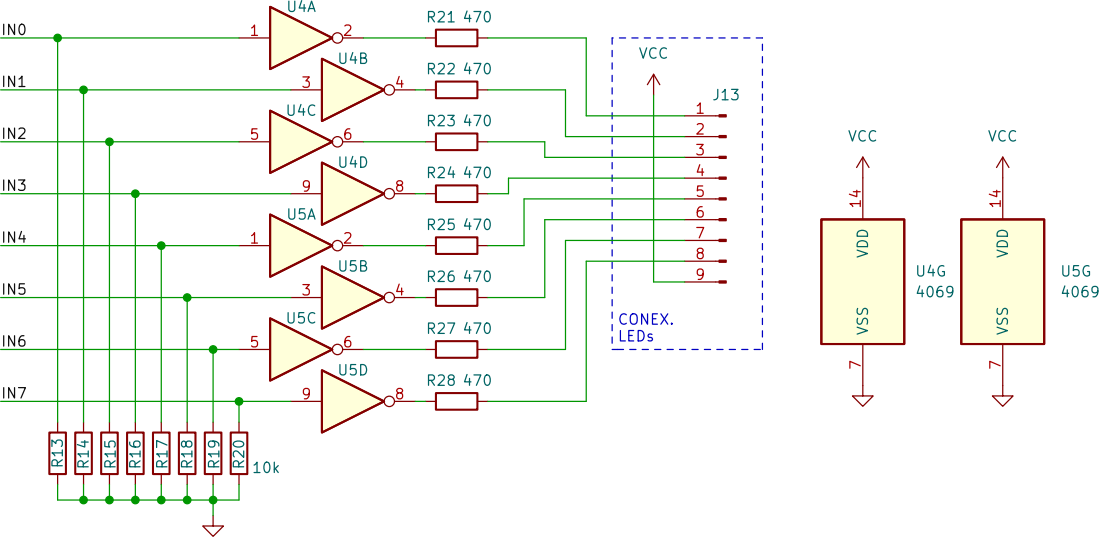
[picture p29: page 1]
