enriquewph/TD1-MiniLab/hw-minilab/docs/sch/individuales/pdf/generador.pdf

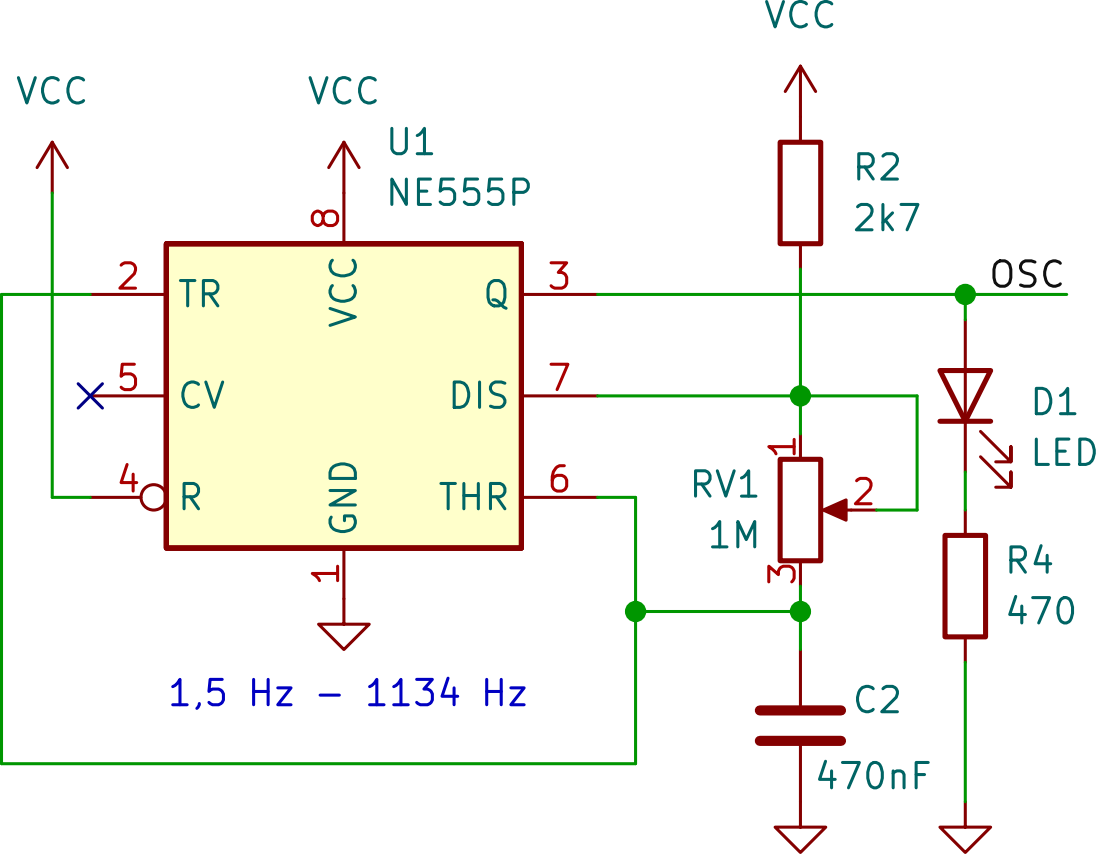
[picture p30: page 1]
