enriquewph/TD1-MiniLab/hw-minilab/docs/sch/individuales/pdf/salidas.pdf

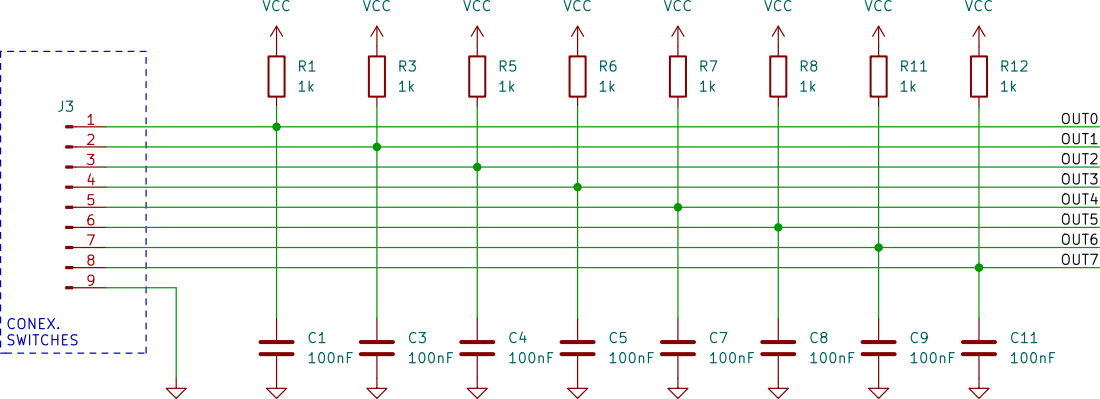
[picture p31: page 1]
