enriquewph/TD1-MiniLab/hw-minilab/minilab.kicad_pcb

## KiCad design hw-minilab/minilab.kicad_pcb (2022-04-10)

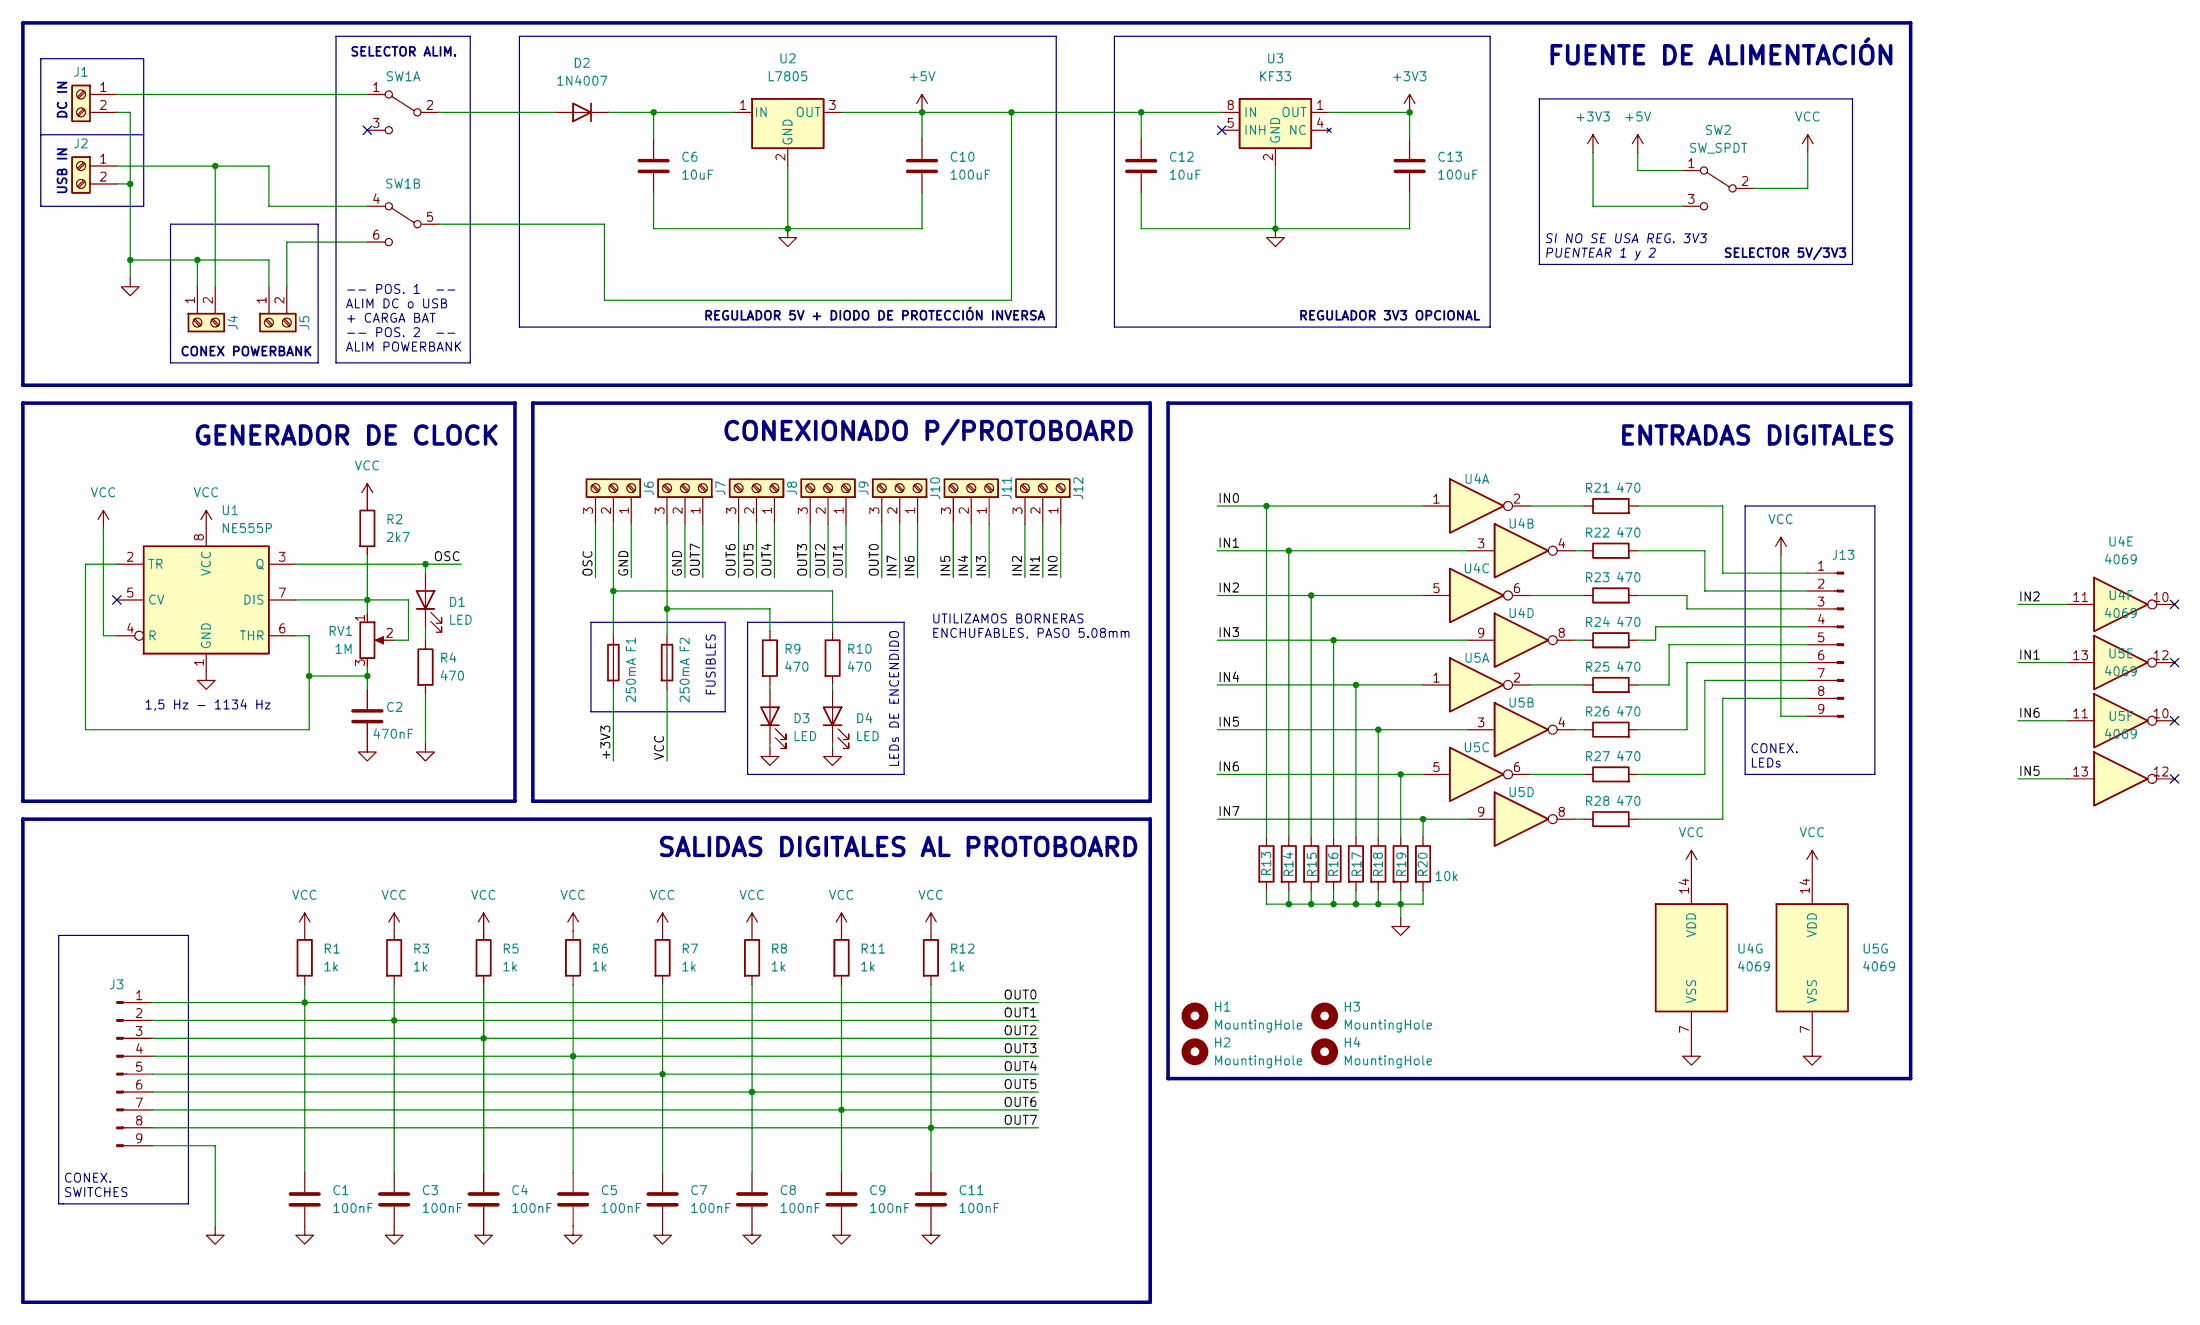
[picture p32: schematic minilab.kicad_sch, Practico de Laboratorio N° 1. --- Mini Lab ---]

Parts:
C1, C3, C4, C5, C7, C8, C9, C11: 100nF; C_Disc_D5.0mm_W2.5mm_P5.00mm
C2: 470nF; C_Disc_D5.0mm_W2.5mm_P5.00mm
C6, C12: 10uF; C_Disc_D5.0mm_W2.5mm_P2.50mm
C10, C13: 100uF; C_Disc_D5.0mm_W2.5mm_P2.50mm
D1, D3, D4: LED; PinHeader_1x02_P2.54mm_Vertical
D2: 1N4007; D_DO-41_SOD81_P10.16mm_Horizontal
F1, F2: 250mA; TestPoint_2Pads_Pitch5.08mm_Drill1.3mm
H1, H2, H3, H4: MountingHole; MountingHole_3.2mm_M3
J1, J2, J4, J5: Screw_Terminal_01x02; TestPoint_2Pads_Pitch5.08mm_Drill1.3mm
J3, J13: Conn_01x09_Male; PinHeader_1x09_P2.54mm_Vertical
J6, J7, J8, J9, J10, J11, J12: Screw_Terminal_01x03; TerminalBlock_RND_205-00288_1x03_P5.08mm_Horizontal
R1, R3, R5, R6, R7, R8, R11, R12: 1k; R_Axial_DIN0207_L6.3mm_D2.5mm_P7.62mm_Horizontal
R2: 2k7; R_Axial_DIN0207_L6.3mm_D2.5mm_P7.62mm_Horizontal
R4, R9, R10, R21, R22, R23, R24, R25, R26, R27, R28: 470; R_Axial_DIN0207_L6.3mm_D2.5mm_P7.62mm_Horizontal
R13, R14, R15, R16, R17, R18, R19, R20: 10k; R_Axial_DIN0207_L6.3mm_D2.5mm_P7.62mm_Horizontal
RV1: 1M; PinHeader_1x03_P2.54mm_Vertical
SW1: SW_DPDT_x2; TestPoint_6Pads_Pitch5.08mm_Drill1.3mm
SW2: SW_SPDT; TestPoint_3Pads_Pitch5.08mm_Drill1.3mm
U1: NE555P; DIP-8_W7.62mm_Socket_LongPads
U2: L7805; TO-220-3_Horizontal_TabUp
U3: KF33; SOIC-8-1EP_3.9x4.9mm_P1.27mm_EP2.29x3mm
U4, U5: 4069

Connections:
+3V3: C13.1, F1.2, SW2.3 (C), U3.1 (OUT)
+5V: C10.1, C12.1, SW1.5 (B), SW2.1 (A), U2.3 (OUT), U3.8 (IN)
/IN0: J12.1, R13.1, U4.1
/IN1: J12.2, R14.1, U4.3, U4.13
/IN2: J12.3, R15.1, U4.5, U4.11
/IN3: J11.1, R16.1, U4.9
/IN4: J11.2, R17.1, U5.1
/IN5: J11.3, R18.1, U5.3, U5.13
/IN6: J10.1, R19.1, U5.5, U5.11
/IN7: J10.2, R20.1, U5.9
/OSC: D1.2 (A), J6.3, U1.3 (Q)
/OUT0: C1.1, J3.1, J10.3, R1.2
/OUT1: C3.1, J3.2, J9.1, R3.2
/OUT2: C4.1, J3.3, J9.2, R5.2
/OUT3: C5.1, J3.4, J9.3, R6.2
/OUT4: C7.1, J3.5, J8.1, R7.2
/OUT5: C8.1, J3.6, J8.2, R8.2
/OUT6: C9.1, J3.7, J8.3, R11.2
/OUT7: C11.1, J3.8, J7.1, R12.2
GND: C1.2, C2.2, C3.2, C4.2, C5.2, C6.2, C7.2, C8.2, C9.2, C10.2, C11.2, C12.2, C13.2, D3.1 (K), D4.1 (K), J1.2, J2.2, J3.9, J4.1, J5.1, J6.1, J7.2, R4.2, R13.2, R14.2, R15.2, R16.2, R17.2, R18.2, R19.2, R20.2, U1.1 (GND), U2.2 (GND), U3.2 (GND), U3.3 (GND), U3.6 (GND), U3.7 (GND), U3.9 (GND), U4.7 (VSS), U5.7 (VSS)
unnamed: C2.1, RV1.3, U1.2 (TR), U1.6 (THR)
unnamed: C6.1, D2.1 (K), U2.1 (IN)
unnamed: D1.1 (K), R4.1
unnamed: D2.2 (A), SW1.2 (B)
unnamed: D3.2 (A), R9.2
unnamed: D4.2 (A), R10.2
unnamed: F1.1, J6.2, R10.1
unnamed: F2.1, J7.3, R9.1
unnamed: J1.1, SW1.1 (A)
unnamed: J2.1, J4.2, SW1.4 (A)
unnamed: J5.2, SW1.6 (C)
unnamed: J13.1, R21.2
unnamed: J13.2, R22.2
unnamed: J13.3, R23.2
unnamed: J13.4, R24.2
unnamed: J13.5, R25.2
unnamed: J13.6, R26.2
unnamed: J13.7, R27.2
unnamed: J13.8, R28.2
unnamed: R2.2, RV1.1, RV1.2, U1.7 (DIS)
unnamed: R21.1, U4.2
unnamed: R22.1, U4.4
unnamed: R23.1, U4.6
unnamed: R24.1, U4.8
unnamed: R25.1, U5.2
unnamed: R26.1, U5.4
unnamed: R27.1, U5.6
unnamed: R28.1, U5.8
VCC: F2.2, J13.9, R1.1, R2.1, R3.1, R5.1, R6.1, R7.1, R8.1, R11.1, R12.1, SW2.2 (B), U1.4 (R), U1.8 (VCC), U4.14 (VDD), U5.14 (VDD)

Notes on the sheet:
SELECTOR 5V/3V3
SALIDAS DIGITALES AL PROTOBOARD
CONEXIONADO P/PROTOBOARD
DC IN
USB IN
UTILIZAMOS BORNERAS ENCHUFABLES, PASO 5.08mm
GENERADOR DE CLOCK
1,5 Hz - 1134 Hz
SI NO SE USA REG. 3V3 PUENTEAR 1 y 2
CONEX. LEDs
CONEX. SWITCHES
ENTRADAS DIGITALES
REGULADOR 5V + DIODO DE PROTECCIÓN INVERSA
LEDs DE ENCENDIDO
REGULADOR 3V3 OPCIONAL
SELECTOR ALIM.
FUSIBLES
-- POS. 1 -- ALIM DC o USB + CARGA BAT -- POS. 2 -- ALIM POWERBANK
FUENTE DE ALIMENTACIÓN
CONEX POWERBANK

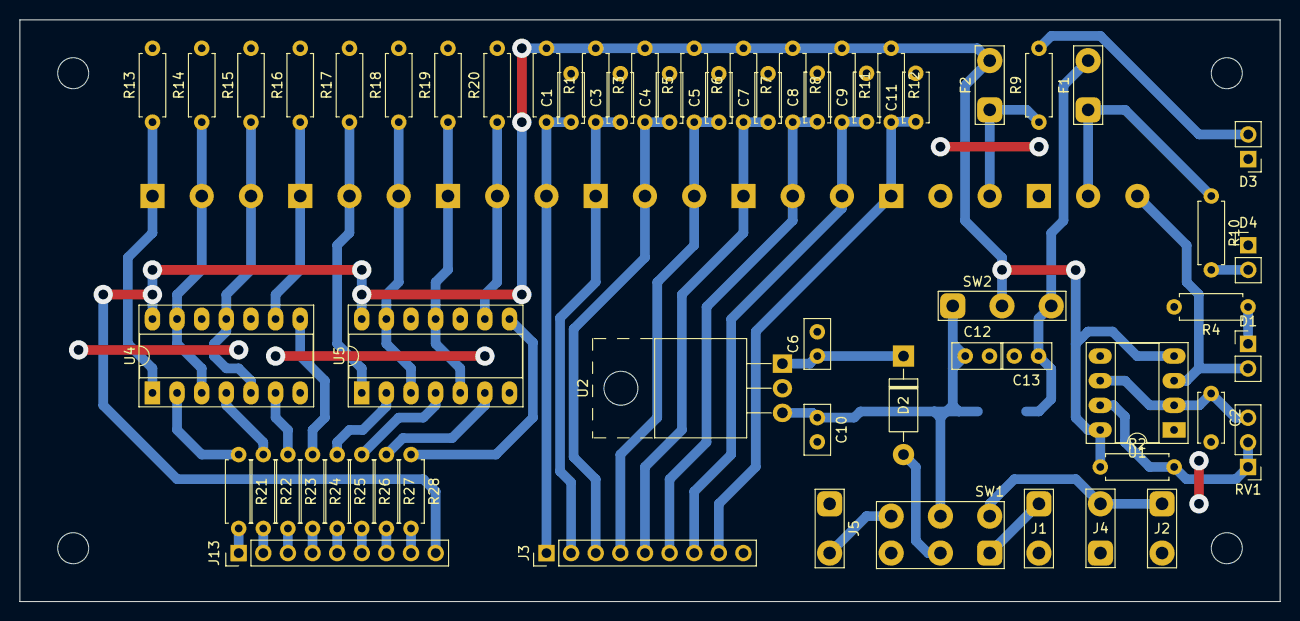
[picture p33: board minilab.kicad_pcb from above]

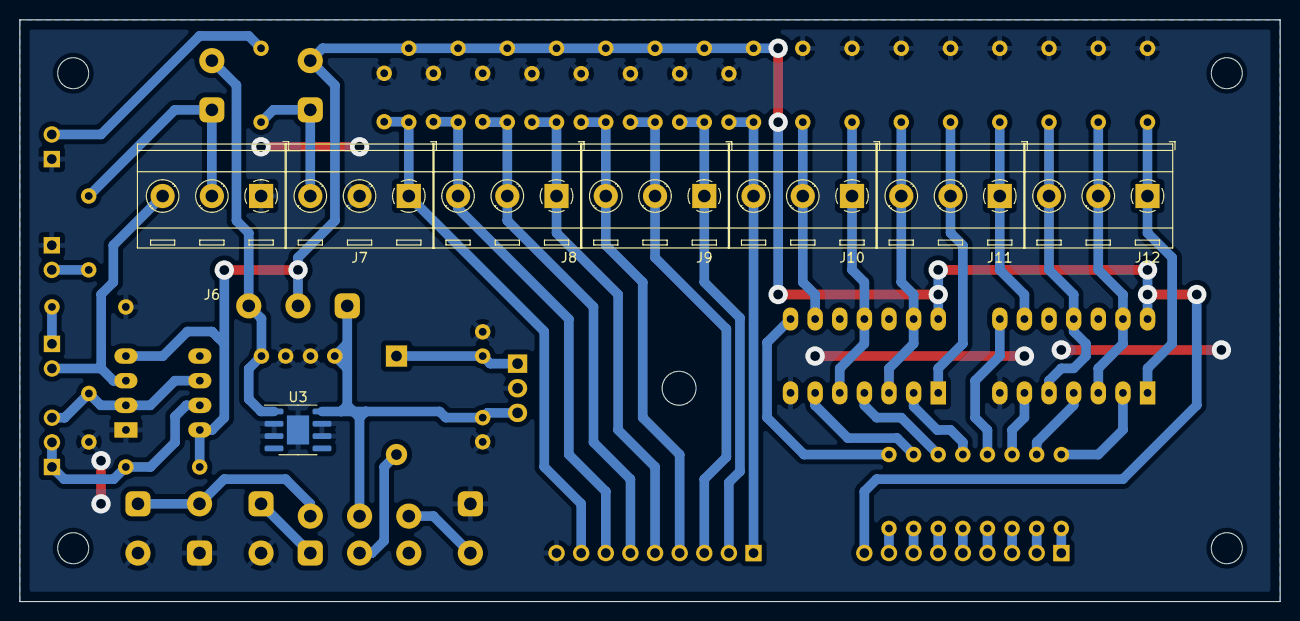
[picture p34: board minilab.kicad_pcb from below]

Board: 2 copper layers, 130.0 x 60.0 mm, 72 parts (8 on the bottom side), 49 nets.
