enriquewph/TD1-MiniLab/(commit log)

2022-03-25 BOM Trabajado en excel
    [BOM.xlsx, minilab.csv]
2022-03-26 Switch 3v3 regulator to kf33
    [minilab.kicad_sch]
2022-03-26 Avances en el routeo
    [2EDGK-5.08-03P-14-00AH.STEP, 2EDGV-5.08-03P-14-00AH.STEP, minilab.kicad_pcb, minilab.kicad_sch]
2022-03-26 Add Preliminar STEP output
    [minilab.kicad_pcb]
2022-03-27 Update BOM
    [BOM.xlsx]
2022-03-28 Archivos de fabricacion generados
    [minilab.kicad_pcb, minilab.kicad_sch]
2022-03-29 Diseños
    [2EDGK-5.08-03P-14-00AH.STEP, 2EDGK-5.08-03P-14-00AH.sldasm, 2EDGK-5.08-03P-14-00AH.step.sldasm, 2EDGK-5.08-03P-14-00AH.step_2.sldasm, 2EDGK-5.08-03P-14-00AH.step_3.sldasm, 2EDGK-5.08-03P-14-00AH.step_4.sldasm, 2EDGK-5.08-03P-14-00AH.step_5.sldasm, 2EDGK-5.08-03P-14-00AH.step_6.sldasm]
2022-03-29 Cambios varios, y export para con y sin insertos
    [Base-Insertos.STL, Base-quique.SLDPRT, Cajon.SLDPRT, Case-quique.SLDPRT, DC Jack Panel Mount Base_1.sldprt, DC Jack Panel Mount Nut_1.sldprt, DPDTINVERSOR.SLDPRT, FuseHolder.SLDPRT]
2022-04-10 Version entregada
    [BOM.xlsx, minilab.kicad_pcb, minilab.kicad_sch]
